franz-schule-tue/AmphibienRoboter/README.md

# AmphibienRoboter
Dies ist das Projekt "Amphibien-Roboter" der Robotik-AG der Französischen Schule Tübingen.
(mehr Infos folgen hoffentlich ...)
