franz-schule-tue/AmphibienRoboter/eagle/Mainboard.sch

## EAGLE design eagle/Mainboard.sch (2021-08-07)

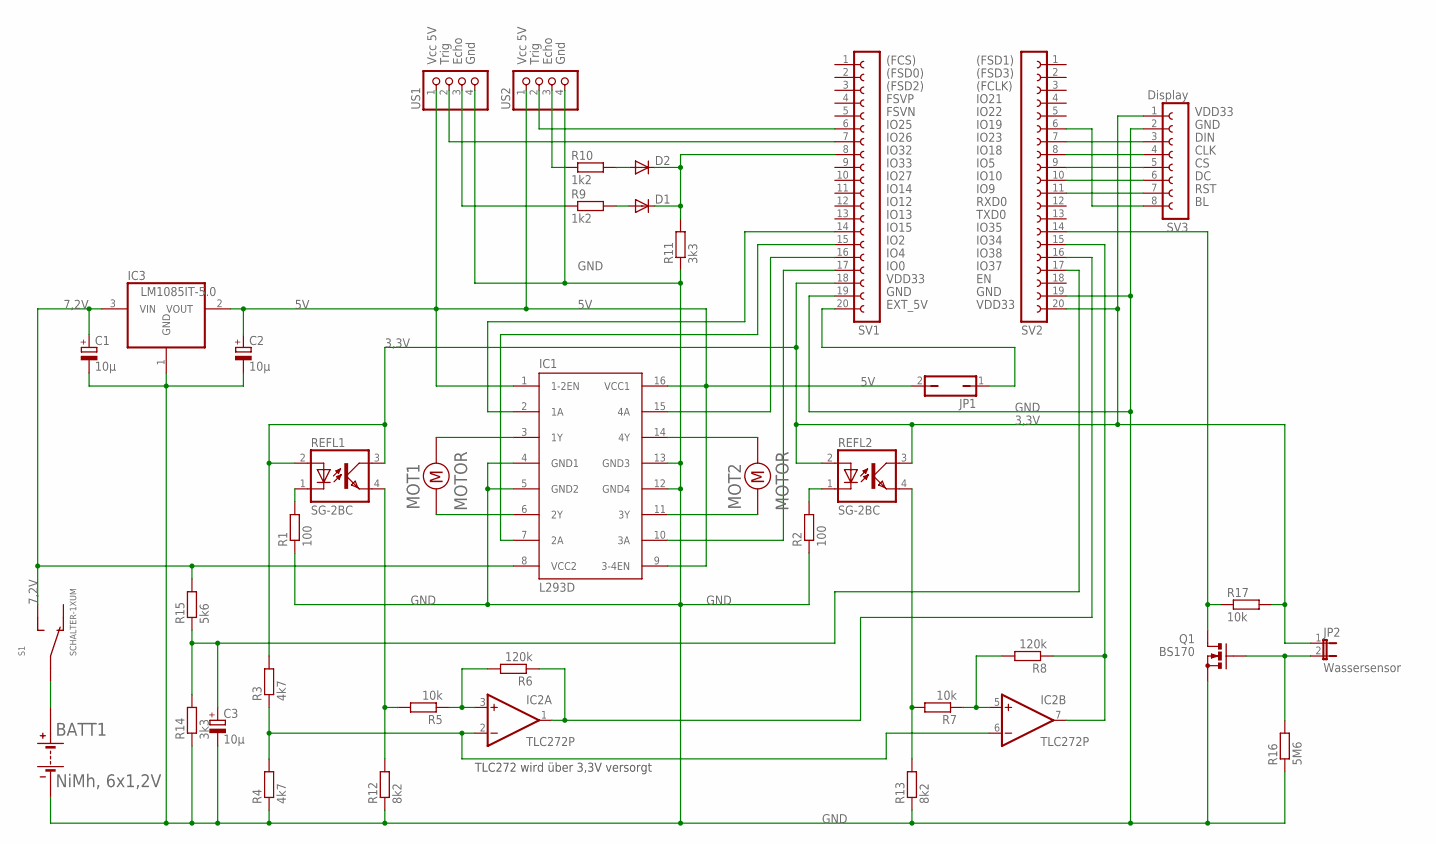
[picture p1: schematic Mainboard.sch]

Parts:
BATT1: NiMh, 6x1,2V; DUMMY2P
C1, C2, C3: 10µ; E3,5-10
D1, D2: 1N4148DO35-10; DO35-10
IC1: L293D; DIL16
IC2: TLC272P; DIL08
IC3: LM1085IT-5.0; DD-3
JP1: JP1Q; JP1
JP2: Wassersensor; JP1
MOT1, MOT2: MOTOR; DUMMY2P
Q1: BS170; SOT54E
R1, R2: 100; RDH/15
R3, R4: 4k7; RDH/15
R5, R7, R17: 10k; RDH/15
R6, R8: 120k; RDH/15
R9, R10: 1k2; RDH/15
R11, R14: 3k3; RDH/15
R12, R13: 8k2; RDH/15
R15: 5k6; RDH/15
R16: 5M6; RDH/15
REFL1, REFL2: SG-2BC; DIL04
S1: SCHALTER-1XUM; DUMMY3P
SV1, SV2: FE20-1; FE20
SV3: Display; FE08
US1, US2: PINHD-1X4; 1X04

Connections:
3,3V: JP2.1, R3.2, R17.2, REFL1.2 (A), REFL1.3 (COL), REFL2.2 (A), REFL2.3 (COL), SV1.18, SV2.20, SV3.1
5V: C2.+, IC1.1 (1-2EN), IC1.9 (3-4EN), IC1.16 (VCC1), IC3.2 (VOUT), JP1.2, US1.1, US2.1
7,2V: C1.+, IC1.8 (VCC2), IC3.3 (VIN), R15.2, S1.P$2
GND: BATT1.P$1 (M), C1.-, C2.-, C3.-, IC1.4 (GND1), IC1.5 (GND2), IC1.12 (GND4), IC1.13 (GND3), IC3.1 (GND), Q1.S, R1.1, R2.1, R4.1, R11.1, R12.1, R13.1, R14.1, R16.1, SV1.19, SV2.19, SV3.2, US1.4, US2.4
unnamed: D1.A, R9.2
unnamed: D2.A, R10.2
unnamed: D1.C, D2.C, R11.2, SV1.8
unnamed: IC1.3 (1Y), MOT1.P$2
unnamed: IC1.6 (2Y), MOT1.P$1
unnamed: IC1.14 (4Y), MOT2.P$2
unnamed: IC1.11 (3Y), MOT2.P$1
unnamed: SV2.7, SV3.3
unnamed: R1.2, REFL1.1 (C)
unnamed: R2.2, REFL2.1 (C)
unnamed: SV2.8, SV3.4
unnamed: SV1.7, US1.2
unnamed: SV1.6, US2.2
unnamed: R9.1, US1.3
unnamed: R10.1, US2.3
unnamed: SV2.9, SV3.5
unnamed: SV2.10, SV3.6
unnamed: SV2.11, SV3.7
unnamed: R5.2, R12.2, REFL1.4 (EMIT)
unnamed: SV2.6, SV3.8
unnamed: IC2.1 (OUT), R6.1, SV2.16
unnamed: IC2.3 (+IN), R5.1, R6.2
unnamed: IC2.2 (-IN), IC2.6 (-IN), R3.1, R4.2
unnamed: IC2.5 (+IN), R7.1, R8.2
unnamed: C3.+, R14.2, R15.1, SV2.17
unnamed: R7.2, R13.2, REFL2.4 (EMIT)
unnamed: JP1.1, SV1.20
unnamed: IC2.7 (OUT), R8.1, SV2.15
unnamed: IC1.10 (3A), SV1.17
unnamed: IC1.15 (4A), SV1.16
unnamed: IC1.2 (1A), SV1.14
unnamed: IC1.7 (2A), SV1.15
unnamed: Q1.D, R17.1, SV2.14
unnamed: JP2.2, Q1.G, R16.2
P: BATT1.P$2, S1.P$1

Notes on the sheet:
(FCS)
(FSD0)
(FSD2)
FSVP
FSVN
IO25
IO26
IO32
IO33
IO27
IO14
IO12
IO13
IO15
IO2
IO4
IO0
VDD33
GND
EXT_5V
(FSD1)
(FSD3)
(FCLK)
IO21
IO22
IO19
IO23
IO18
IO5
IO10
IO9
RXD0
TXD0
IO35
IO34
IO38
IO37
Vcc 5V
Trig
Echo
Gnd
DIN
CLK
RST
TLC272 wird über 3,3V versorgt
