franz-schule-tue/AmphibienRoboter/(threads)

Thread 6 (2021-02-26):

Schaltplan: Akkuspannung messen

franz-schule-tue, 2021-02-26:
Damit der Roboter erkennen kann, wenn sein Akku leer wird, muss er dessen Spannung messen und anzeigen bzw. ans Handy senden können. Dies muss im Schaltplan ergänzt werden

Closed 2021-07-27.
