franz-schule-tue/AmphibienRoboter/arduino/Mainboard/Mainboard.ino

#include <Wire.h>
#include <TFT_eSPI.h>
#include <BluetoothSerial.h>

#include "motor.hpp"
#include "us_sensor.hpp"

// Definition der Mikrocontroller-Pins
#define PIN_ANAIN_BATT          37
#define PIN_ENC_LEFT            34
#define PIN_ENC_RIGHT           38
#define PIN_MOTOR_P_LEFT        15
#define PIN_MOTOR_M_LEFT        2
#define PIN_MOTOR_P_RIGHT       4
#define PIN_MOTOR_M_RIGHT       0
#define PIN_US_TRIG1            26
#define PIN_US_TRIG2            25
#define PIN_US_ECHO             32
#define PIN_WATER_SENS          35
#define PWM_CHAN_LEFT           0
#define PWM_CHAN_RIGHT          1  

#define DISP_FONT_NORMAL     2
#define DISP_FROM_LEFT       10
#define DISP_FROM_TOP        2
#define DISP_CENTER          64

#define PERIOD_BATT          1000


TFT_eSPI        disp;
BluetoothSerial bt;
hw_timer_t*     timer = nullptr;
Motor           motorLeft{  PIN_MOTOR_P_LEFT,  PIN_MOTOR_M_LEFT,  PWM_CHAN_LEFT  };
Motor           motorRight{ PIN_MOTOR_P_RIGHT, PIN_MOTOR_M_RIGHT, PWM_CHAN_RIGHT };
USSensorControl usControl{ PIN_US_ECHO, 1 };
USSensor*       usFront = nullptr;
USSensor*       usBack  = nullptr;

int count = 0;
float vBatt = 0;
unsigned long alarmBatt = 0;
int us1;
int lastUs1 = -1;
int us2;
int lastUs2 = -1;
boolean isInWater;


// Variablen, die im Interrupt verändert werden, müssen mit "volatile" deklariert werden, sonst werden die Änderungen evtl. nicht sichtbar
volatile int  countLeft  = 0;
volatile int  countRight = 0;
volatile int  lastCountLeft  = 0;
volatile int  lastCountRight = 0;
volatile int  speedLeft  = 0;
volatile int  speedRight = 0;
volatile bool changed    = true;
volatile bool connected  = false;


// Interrupt-Funktion (Interrupt Service Function = ISR) für den linken Sensor
void IRAM_ATTR isrEncLeft()
{
    ++countLeft;
}


// Interrupt-Funktion für den rechten Sensor
void IRAM_ATTR isrEncRight()
{
    ++countRight;
}


// Interrupt-Funktion für den Timer
void IRAM_ATTR isrTimer()
{
    speedLeft = ( countLeft - lastCountLeft );
    lastCountLeft = countLeft;

    speedRight = ( countRight - lastCountRight );
    lastCountRight = countRight;

    changed = true;
}


void onBluetoothEvent(esp_spp_cb_event_t event, esp_spp_cb_param_t *param)
{
    if (  event == ESP_SPP_SRV_OPEN_EVT )
    {
        // verbunden
        connected = true;
    }
    else if(event == ESP_SPP_CLOSE_EVT )
    {
        // unterbrochen 
        connected = false;
        motorLeft.setPower( 0 );
        motorRight.setPower( 0 );
    }
}


void initDisplay()
{
    disp.init();
    disp.fillScreen( TFT_BLACK );
    
    disp.drawString( "Akku   ",  DISP_FROM_LEFT, DISP_FROM_TOP, DISP_FONT_NORMAL );
    disp.drawString( "Abst. V",  DISP_FROM_LEFT, DISP_FROM_TOP + 1 * disp.fontHeight( DISP_FONT_NORMAL ), DISP_FONT_NORMAL );
    disp.drawString( "Abst. H",  DISP_FROM_LEFT, DISP_FROM_TOP + 2 * disp.fontHeight( DISP_FONT_NORMAL ), DISP_FONT_NORMAL );
    disp.drawString( "Imp.  L",  DISP_FROM_LEFT, DISP_FROM_TOP + 3 * disp.fontHeight( DISP_FONT_NORMAL ), DISP_FONT_NORMAL );
    disp.drawString( "Imp.  R",  DISP_FROM_LEFT, DISP_FROM_TOP + 4 * disp.fontHeight( DISP_FONT_NORMAL ), DISP_FONT_NORMAL );
    disp.drawString( "GeschwL",  DISP_FROM_LEFT, DISP_FROM_TOP + 5 * disp.fontHeight( DISP_FONT_NORMAL ), DISP_FONT_NORMAL );
    disp.drawString( "GeschwR",  DISP_FROM_LEFT, DISP_FROM_TOP + 6 * disp.fontHeight( DISP_FONT_NORMAL ), DISP_FONT_NORMAL );
    disp.drawString( "connect",  DISP_FROM_LEFT, DISP_FROM_TOP + 7 * disp.fontHeight( DISP_FONT_NORMAL ), DISP_FONT_NORMAL );
    disp.drawString( "water",    DISP_FROM_LEFT, DISP_FROM_TOP + 8 * disp.fontHeight( DISP_FONT_NORMAL ), DISP_FONT_NORMAL );
}


float measureBatt()
{
    // so wäre es nach der Theorie:
    //return analogRead( PIN_ANAIN_BATT ); //* 3.3 / 4095.0 * ( 5600.0 + 3300.0 ) / 3300.0;

    // tatsächlich scheint der ESP32 laut Datenblatt keine so genaue interne Referenzspannung zu haben und auch
    // zu den höherne Werten hin etwas ungenauer zu sein. Daher haben wir die genauen Werte durch Kalibrierung ermittelt,
    // wobei wir sogar einen Offset beobachtet haben:
    return 0.002243 * analogRead( PIN_ANAIN_BATT ) + 0.3257;
}


void displayBatt( float value )
{
    if ( value < 6.0 )
    {
        disp.setTextColor( TFT_BLACK, TFT_RED );
    }
    else if ( value < 6.5 ) 
    {
        disp.setTextColor( TFT_BLACK, TFT_ORANGE );
    }
    else if ( value < 7 ) 
    {
        disp.setTextColor( TFT_BLACK, TFT_YELLOW );
    }
    else
    {
        disp.setTextColor( TFT_BLACK, TFT_GREEN );
    }
    

    disp.drawString( String( value ), TFT_WIDTH / 2, DISP_FROM_TOP, DISP_FONT_NORMAL );

    disp.setTextColor( TFT_WHITE, TFT_BLACK );    
    //disp.drawString( String( value ), DISP_FROM_LEFT, DISP_FROM_TOP + 10 + 7 * disp.fontHeight( DISP_FONT_NORMAL ), 4 );
}


void displayValue( int line, int value )
{
    disp.drawString( String( value ) + "  ", TFT_WIDTH / 2, DISP_FROM_TOP + ( line - 1 ) * disp.fontHeight( DISP_FONT_NORMAL ), DISP_FONT_NORMAL );
}


void outputIfChanged( USSensor* sensor, int line, const char* name )
{
    if ( sensor->hasChanged() )
    {
        int dist = sensor->getDistance();
        displayValue( line, dist );

        if ( bt.hasClient() )
        {
            bt.print( name );
            bt.print( dist );
            bt.print( ";" );
        }
    }
}



void setup()
{
    initDisplay();

    pinMode( PIN_ENC_LEFT,   INPUT );
    pinMode( PIN_ENC_RIGHT,  INPUT );
    pinMode( PIN_WATER_SENS, INPUT_PULLUP );

    // Pin-Change-Interrupts setzen und die Interrupt-Funktionen zuweisen
    attachInterrupt( digitalPinToInterrupt( PIN_ENC_LEFT  ), isrEncLeft,  CHANGE );
    attachInterrupt( digitalPinToInterrupt( PIN_ENC_RIGHT ), isrEncRight, CHANGE );

    usFront = usControl.createSensor( PIN_US_TRIG1 );
    usBack  = usControl.createSensor( PIN_US_TRIG2 );
  

    // Timer erstellen und initialisieren:
    // - Timer0 verwenden
    // - Vorteiler (Prescaler) auf 80. Bei einer Taktfrequenz des Mikrocontrollers von 80MHz ergibt das eine Taktfrequenz des Timers von 1MHz
    // - hochzählen
    timer = timerBegin( 0, 80, true );

    // mit Interrupt-Funktion verknüpfen
    timerAttachInterrupt( timer, isrTimer, true );

    // Ende-Wert auf 500000, also 500ms setzen mit automatischer Wiederholung
    timerAlarmWrite( timer, 500000, true );

    // Timer starten
    timerAlarmEnable( timer );

    bt.register_callback( onBluetoothEvent );
    bt.begin( "ESP32" );

    // für Debug-Ausgaben:
    //Serial.begin( 115200 );
    //Serial.println( "Hallo!\r\n" );

    usControl.start();
}




void loop()
{
    unsigned long now = millis();

    if ( now >= alarmBatt )
    {
        // es ist wieder Zeit für die nächste Batteriemessung

        alarmBatt += PERIOD_BATT;
        
        float vBattNew = measureBatt();
        if ( vBattNew != vBatt )
        {
            vBatt = vBattNew;
            displayBatt( vBatt ); 
        }

        if ( bt.hasClient() )
        {
            bt.print( "BA");
            bt.print( vBatt );
            bt.print( ";" );
        }
    }

    outputIfChanged( usFront, 2, "DF" );
    outputIfChanged( usBack,  3, "DB" );

    isInWater = digitalRead( PIN_WATER_SENS ) == LOW;
    
    if ( changed )
    {
        changed = false;

        displayValue( 4, countLeft );
        displayValue( 5, countRight );
        displayValue( 6, speedLeft * 120 / 96 );
        displayValue( 7, speedRight * 120 / 96 );
        displayValue( 8, connected );
        displayValue( 9, isInWater );

        if ( bt.hasClient() )
        {
            bt.print( "CL" );
            bt.print( countLeft );
            bt.print( ";" );
            bt.print( "CR" );
            bt.print( countRight );
            bt.print( ";" );
            bt.print( "SL" );
            bt.print( speedLeft * 120 / 96 );
            bt.print( ";" );
            bt.print( "SR" );
            bt.print( speedRight * 120 / 96 );
            bt.print( ";" );
        }
    }


    if ( bt.available() )
    {
        String rd = bt.readStringUntil( ';' );
        if ( rd.startsWith( "ML" ) )
        {
            motorLeft.setPower( rd.substring( 2 ).toInt() );
        }
        else if ( rd.startsWith( "MR" ) )
        {
            motorRight.setPower( rd.substring( 2 ).toInt() );
        }
    }
}
