franz-schule-tue/AmphibienRoboter/(commit log)

2021-02-16 Dateien aufgenommen
    [Mainboard.sch]
2021-02-19 erweitert um Ultraschallsensoren
    [Mainboard.sch]
2021-02-21 Display hinzugefügt
    [Mainboard.sch]
2021-02-22 Kondensatoren um Spannungsregler hinzugefügt
    [Mainboard.sch]
2021-02-27 Messung Akkuspannung hinzugefügt. SPI-Pins verschoben, damit sie mit SPI3 zusammenpassen
    [Mainboard.sch]
2021-03-06 Sketch für Mainboard hinzugefügt
    [Mainboard.sch]
2021-03-08 Encoder hinzugefügt
2021-03-14 5V-Jumper hinzugefügt und Spanungsteiler für Akkumessung angepasst
    [Mainboard.sch]
2021-03-14 Motoransteuerung hinzugefügt
2021-03-16 Klasse zur Motoransteuerung erstellt
2021-05-01 Problem mit Geister-Impulsen vom US-Sensor behoben
    [Mainboard.ino, us_sensor.hpp]
2021-08-07 Wassersensor hinzugefügt
    [Mainboard.sch]
